citroale90/pi-dock-wifi/hardware/3d/placca base ventola pi con hat.stl

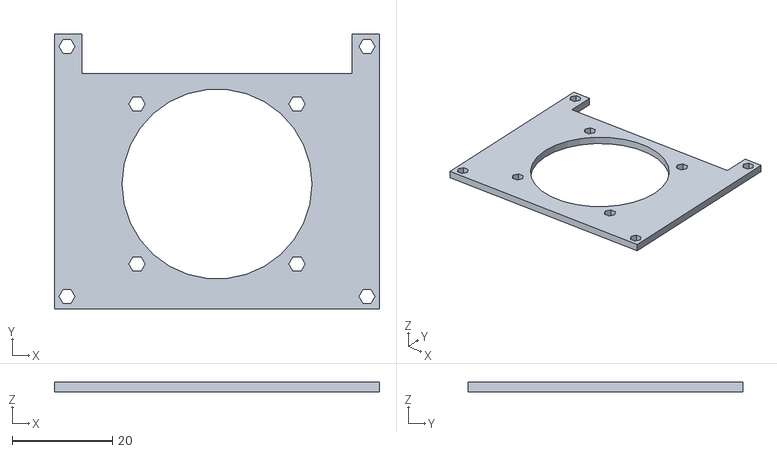
[picture p4: CAD file, 2026-11-11]
hardware/3d/placca base ventola pi con hat.stl
65.0 x 55.0 x 2.00
