citroale90/pi-dock-wifi/hardware/3d/placca antenne ventola pi.stl

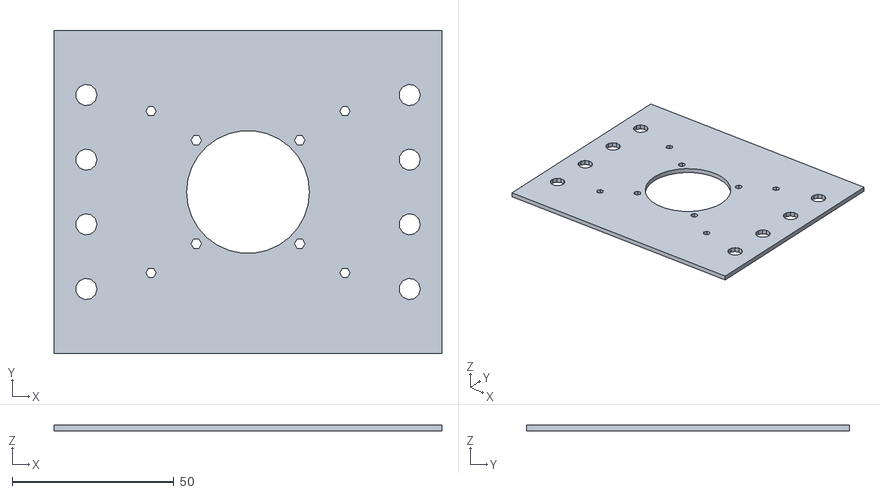
[picture p5: CAD file, 2026-11-11]
hardware/3d/placca antenne ventola pi.stl
120.0 x 100.0 x 2.00
