citroale90/pi-dock-wifi/hardware/3d/usb cover.stl

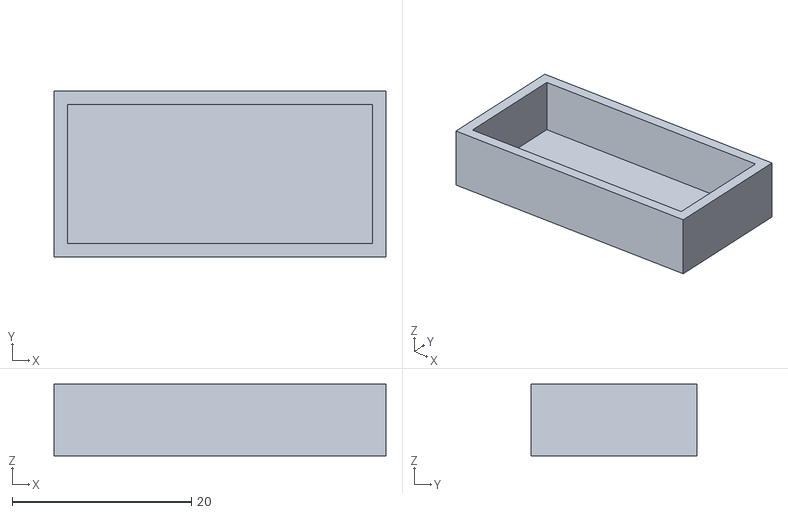
[picture p6: CAD file, 2026-11-11]
hardware/3d/usb cover.stl
37.0 x 18.5 x 8.00
